jagt48/uart_expander/serial_logger_uart_expander.kicad_pcb

## KiCad design serial_logger_uart_expander.kicad_pcb (2021-09-15)

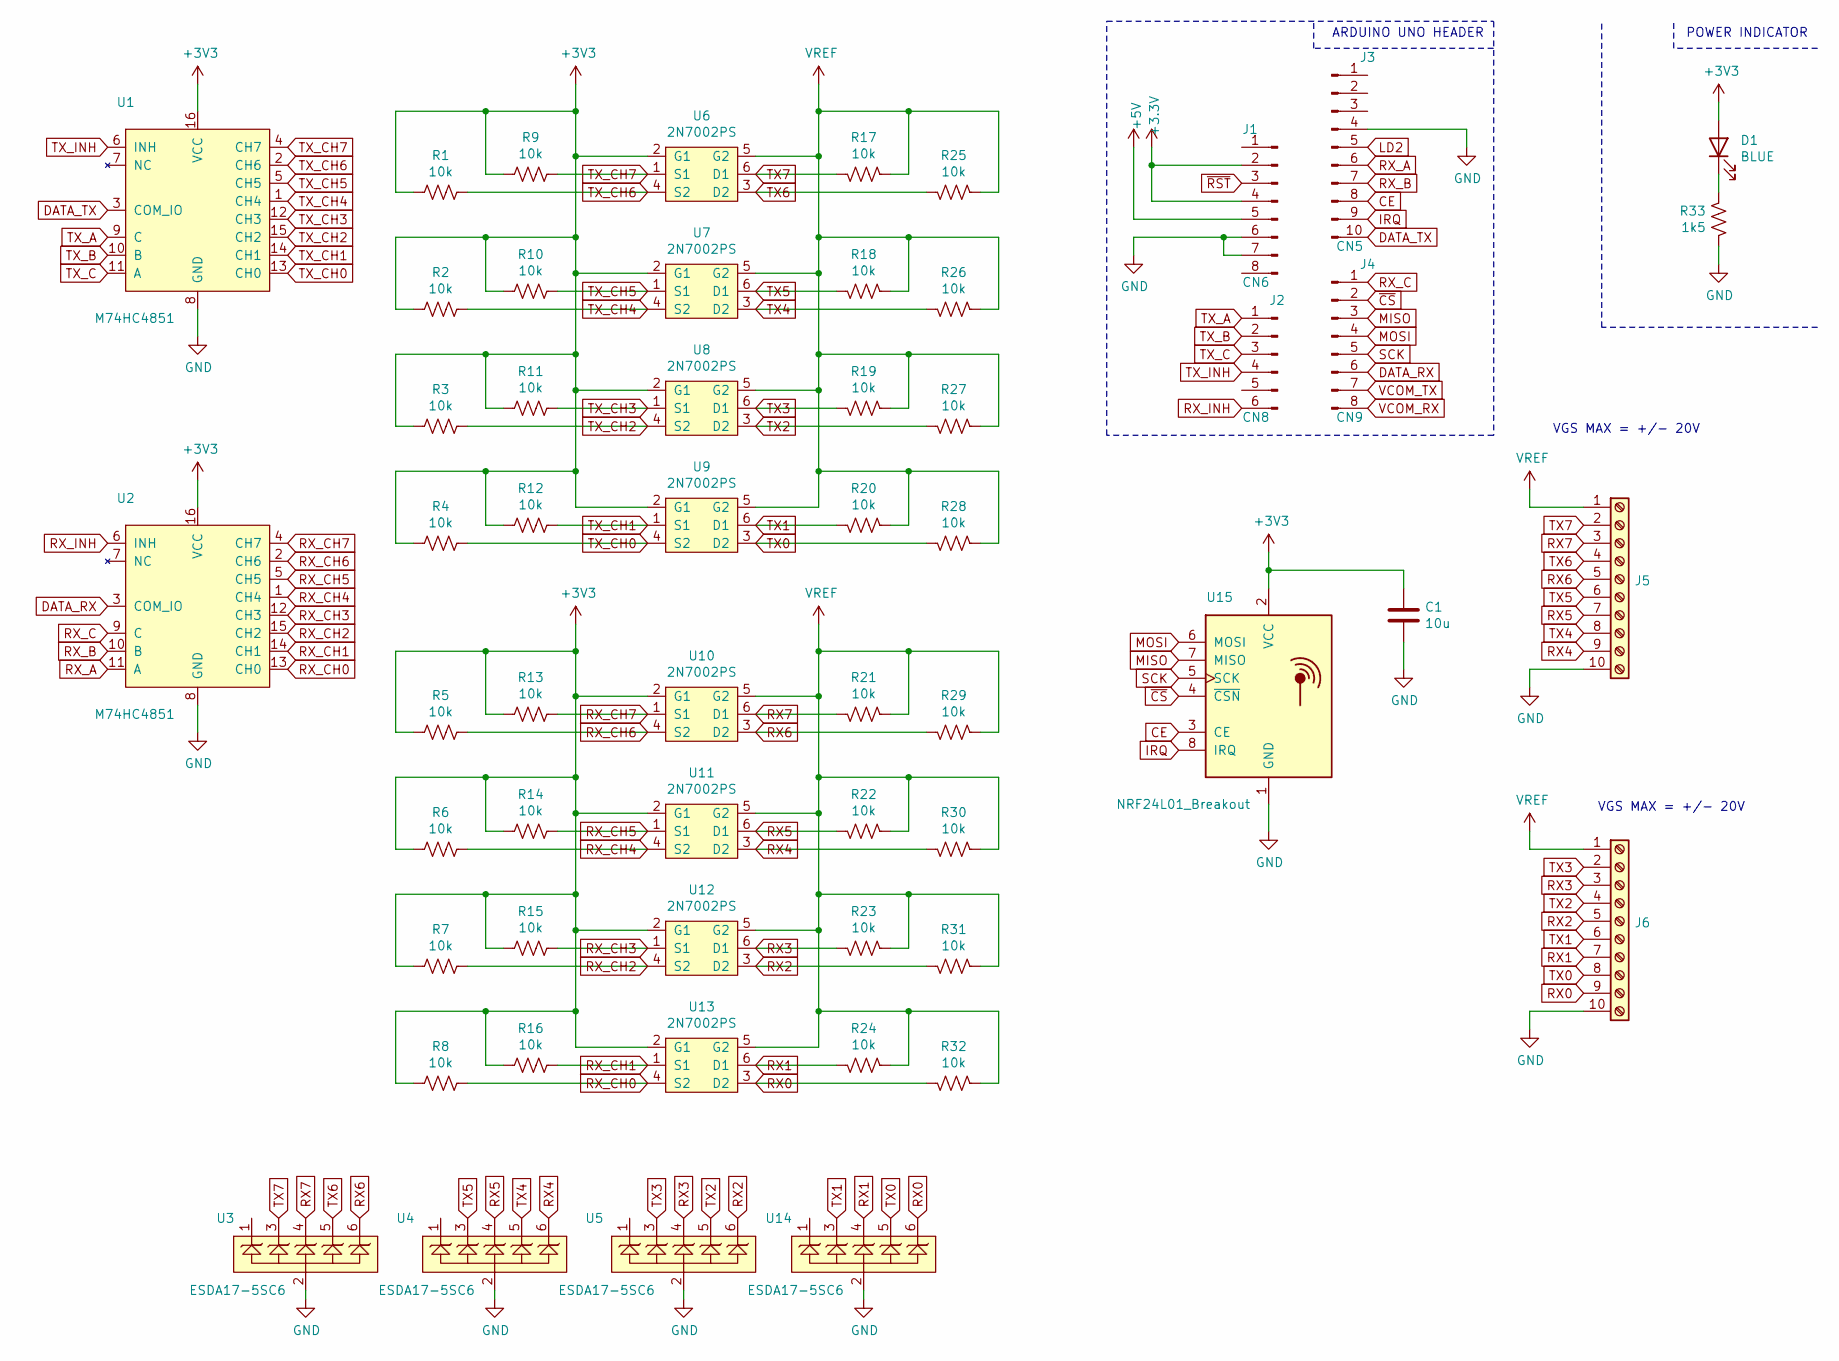
[picture p1: schematic serial_logger_uart_expander.sch]

Parts:
C1: 10u; C_0805_2012Metric; LCSC Part # C15850
D1: BLUE; LED_0603_1608Metric_Castellated; LCSC Part # C72041
J1: CN6; PinHeader_1x08_P2.54mm_Vertical
J2: CN8; PinHeader_1x06_P2.54mm_Vertical
J3: CN5; PinHeader_1x10_P2.54mm_Vertical
J4: CN9; PinHeader_1x08_P2.54mm_Vertical
J5, J6: Screw_Terminal_01x10; TerminalBlock_TE_1-282834-0_1x10_P2.54mm_Horizontal
R1, R2, R3, R4, R5, R6, R7, R8, R9, R10, R11, R12, R13, R14, R15, R16, R17, R18, R19, R20, R21, R22, R23, R24, R25, R26, R27, R28, R29, R30, R31, R32: 10k; R_0603_1608Metric; LCSC Part # C25804
R33: 1k5; R_0603_1608Metric; LCSC Part # C22843
U1, U2: M74HC4851; M74HC4851_ST_TSSOP-16
U3, U4, U5, U14: ESDA17-5SC6; ESDA17-5SC6_SOT23-6L
U6, U7, U8, U9, U10, U11, U12, U13: 2N7002PS; 2N7002PS_NEXPERA_SOT-363
U15: NRF24L01_Breakout; nRF24L01_Breakout

Connections:
+5V: J1.5
CE: J3.8, U15.3 (CE)
DATA_RX: J4.6, U2.3 (COM_IO)
DATA_TX: J3.10, U1.3 (COM_IO)
GND: C1.2, J1.6, J1.7, J3.4, J5.10, J6.10, R33.1, U1.8 (GND), U2.8 (GND), U3.2, U4.2, U5.2, U14.2, U15.1 (GND)
IRQ: J3.9, U15.8 (IRQ)
LD2: J3.5
MISO: J4.3, U15.7 (MISO)
MOSI: J4.4, U15.6 (MOSI)
unnamed: D1.1 (K), R33.2
RX0: J6.9, R32.2, U13.3 (D2), U14.6
RX1: J6.7, R24.2, U13.6 (D1), U14.4
RX2: J6.5, R31.2, U5.6, U12.3 (D2)
RX3: J6.3, R23.2, U5.4, U12.6 (D1)
RX4: J5.9, R30.2, U4.6, U11.3 (D2)
RX5: J5.7, R22.2, U4.4, U11.6 (D1)
RX6: J5.5, R29.2, U3.6, U10.3 (D2)
RX7: J5.3, R21.2, U3.4, U10.6 (D1)
RX_A: J3.6, U2.11 (A)
RX_B: J3.7, U2.10 (B)
RX_C: J4.1, U2.9 (C)
RX_CH0: R8.1, U2.13 (CH0), U13.4 (S2)
RX_CH1: R16.1, U2.14 (CH1), U13.1 (S1)
RX_CH2: R7.1, U2.15 (CH2), U12.4 (S2)
RX_CH3: R15.1, U2.12 (CH3), U12.1 (S1)
RX_CH4: R6.1, U2.1 (CH4), U11.4 (S2)
RX_CH5: R14.1, U2.5 (CH5), U11.1 (S1)
RX_CH6: R5.1, U2.2 (CH6), U10.4 (S2)
RX_CH7: R13.1, U2.4 (CH7), U10.1 (S1)
RX_INH: J2.6, U2.6 (INH)
SCK: J4.5, U15.5 (SCK)
TX0: J6.8, R28.2, U9.3 (D2), U14.5
TX1: J6.6, R20.2, U9.6 (D1), U14.3
TX2: J6.4, R27.2, U5.5, U8.3 (D2)
TX3: J6.2, R19.2, U5.3, U8.6 (D1)
TX4: J5.8, R26.2, U4.5, U7.3 (D2)
TX5: J5.6, R18.2, U4.3, U7.6 (D1)
TX6: J5.4, R25.2, U3.5, U6.3 (D2)
TX7: J5.2, R17.2, U3.3, U6.6 (D1)
TX_A: J2.1, U1.9 (C)
TX_B: J2.2, U1.10 (B)
TX_C: J2.3, U1.11 (A)
TX_CH0: R4.1, U1.13 (CH0), U9.4 (S2)
TX_CH1: R12.1, U1.14 (CH1), U9.1 (S1)
TX_CH2: R3.1, U1.15 (CH2), U8.4 (S2)
TX_CH3: R11.1, U1.12 (CH3), U8.1 (S1)
TX_CH4: R2.1, U1.1 (CH4), U7.4 (S2)
TX_CH5: R10.1, U1.5 (CH5), U7.1 (S1)
TX_CH6: R1.1, U1.2 (CH6), U6.4 (S2)
TX_CH7: R9.1, U1.4 (CH7), U6.1 (S1)
TX_INH: J2.4, U1.6 (INH)
VBUS: J5.1, J6.1, R17.1, R18.1, R19.1, R20.1, R21.1, R22.1, R23.1, R24.1, R25.1, R26.1, R27.1, R28.1, R29.1, R30.1, R31.1, R32.1, U6.5 (G2), U7.5 (G2), U8.5 (G2), U9.5 (G2), U10.5 (G2), U11.5 (G2), U12.5 (G2), U13.5 (G2)
VCOM_RX: J4.8
VCOM_TX: J4.7
~CS: J4.2, U15.4 (~CSN)
~RST: J1.3

Notes on the sheet:
POWER INDICATOR
VGS MAX = +/- 20V
ARDUINO UNO HEADER

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
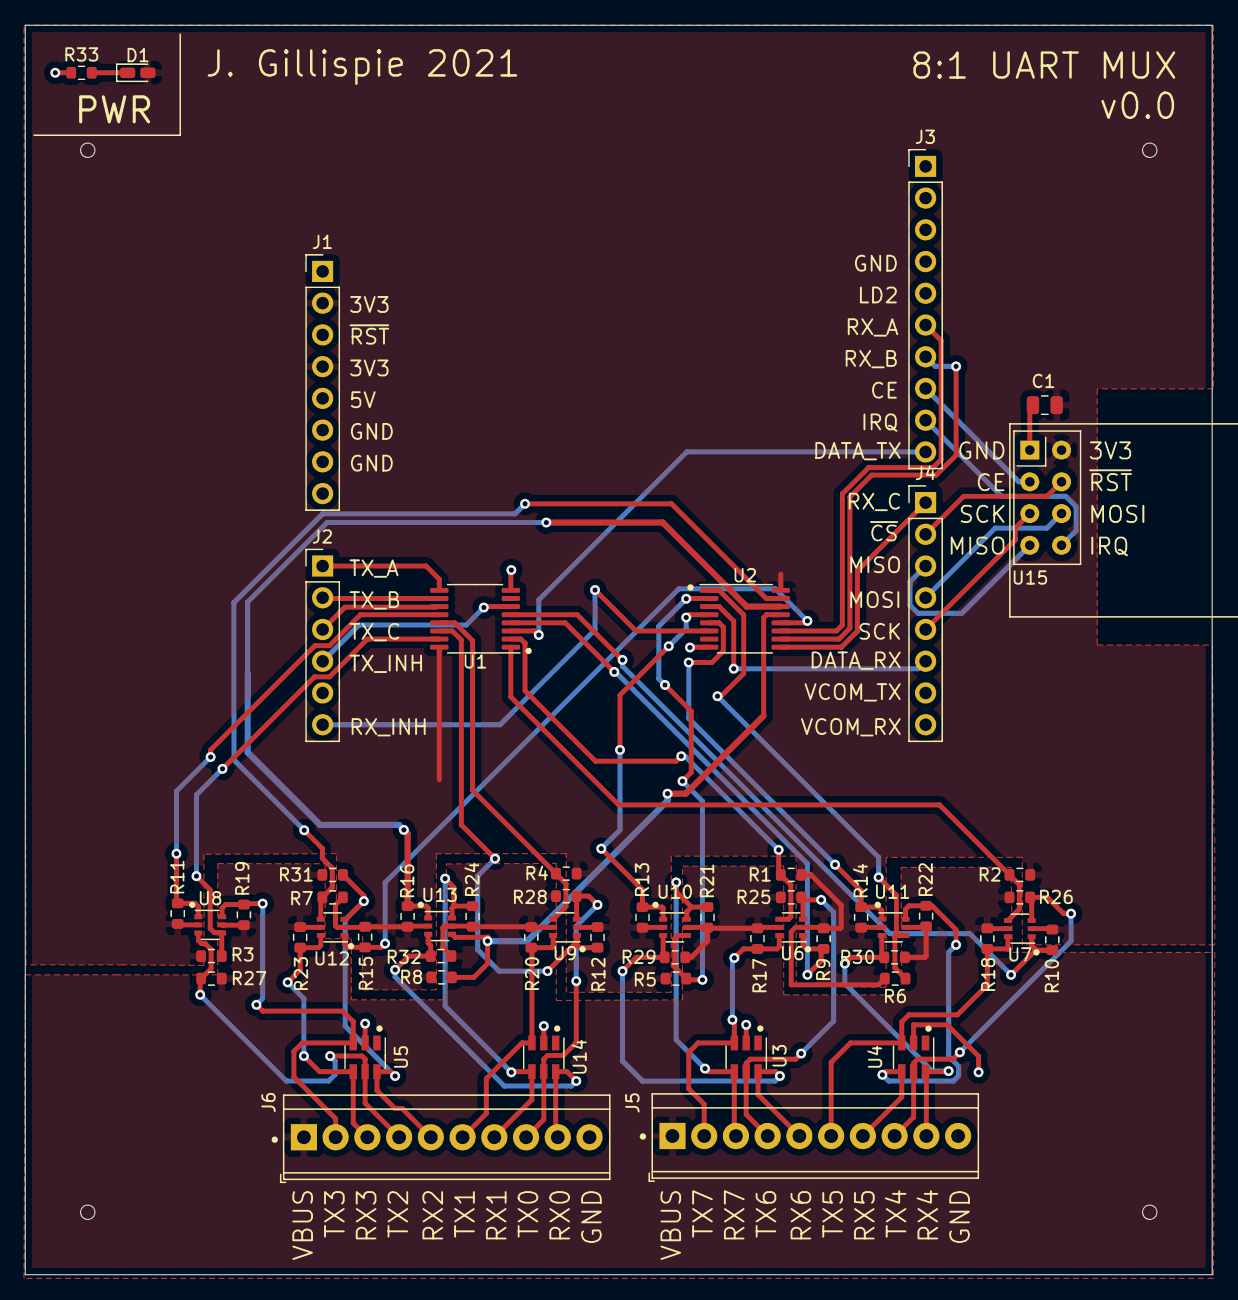
[picture p2: board serial_logger_uart_expander.kicad_pcb from above]

Board: 2 copper layers, 95.0 x 100.0 mm, 56 parts (0 on the bottom side), 52 nets.
