jagt48/uart_expander/(commit log)

2021-09-01 added all libs, sch, and pcb files
    [serial_logger_uart_expander.kicad_pcb, serial_logger_uart_expander.sch]
2021-09-07 rearranged components and traces
    [serial_logger_uart_expander.kicad_pcb, serial_logger_uart_expander.sch]
2021-09-14 completed design, no gerbers or BOM.
    [serial_logger_uart_expander.kicad_pcb, serial_logger_uart_expander.sch]
2021-09-15 v0.0 completed
    [serial_logger_uart_expander-B_Cu.gbl, serial_logger_uart_expander-B_Mask.gbs, serial_logger_uart_expander-B_Paste.gbp, serial_logger_uart_expander-B_SilkS.gbo, serial_logger_uart_expander-Edge_Cuts.gm1, serial_logger_uart_expander-F_Cu.gtl, serial_logger_uart_expander-F_Mask.gts, serial_logger_uart_expander-F_Paste.gtp]
